archieroques/LEDMatrix/README.md

# LEDMatrix
An LED Matrix project, originally completed for a Gold CREST award. 

All stuff is Open Source - Released under CC-BY-SA-NC 3.0

Matrix isn't necessarily 100% working - you were warned - no guarantees!
