archieroques/LEDMatrix/LEDMatrixPres_FINAL.pdf

# LED Matrix

## Research

Screen image¹

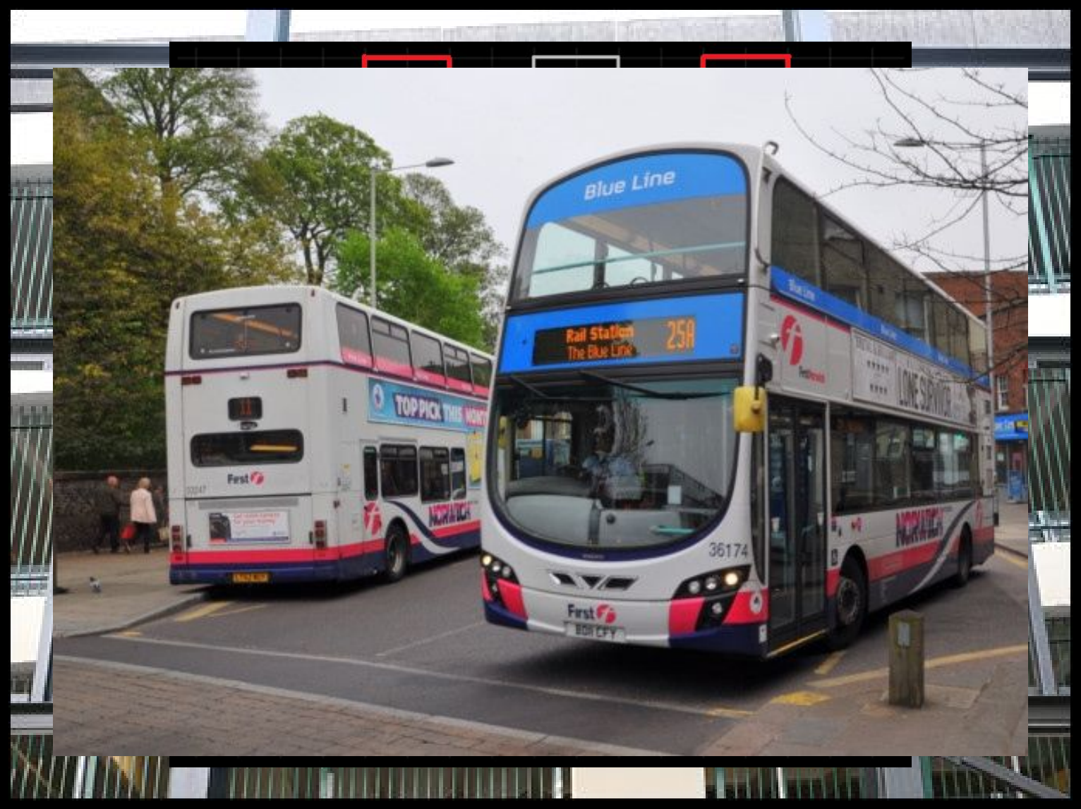
[picture p11: figure]

, bus image²

## Design

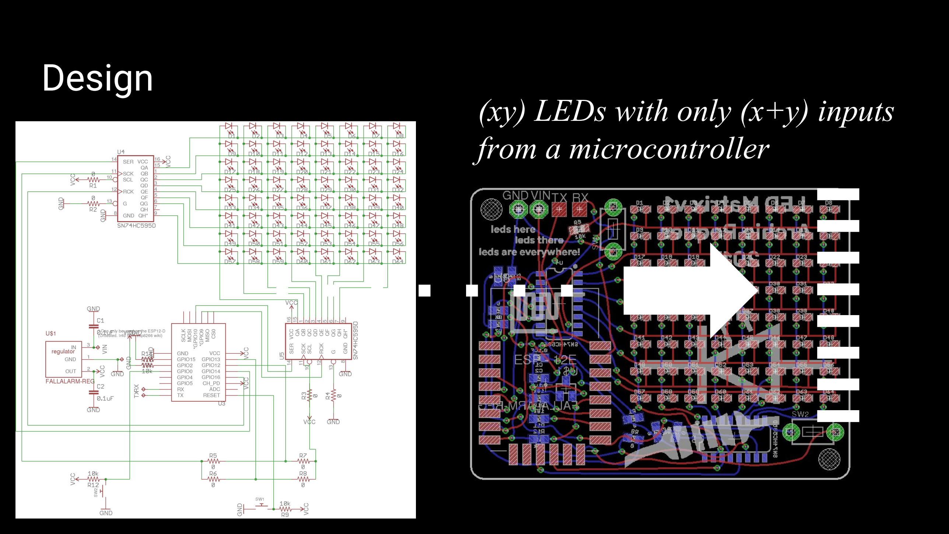
[picture p12: page 3]

### (xy) LEDs with only (x+y) inputs from a microcontroller

## Manufacture

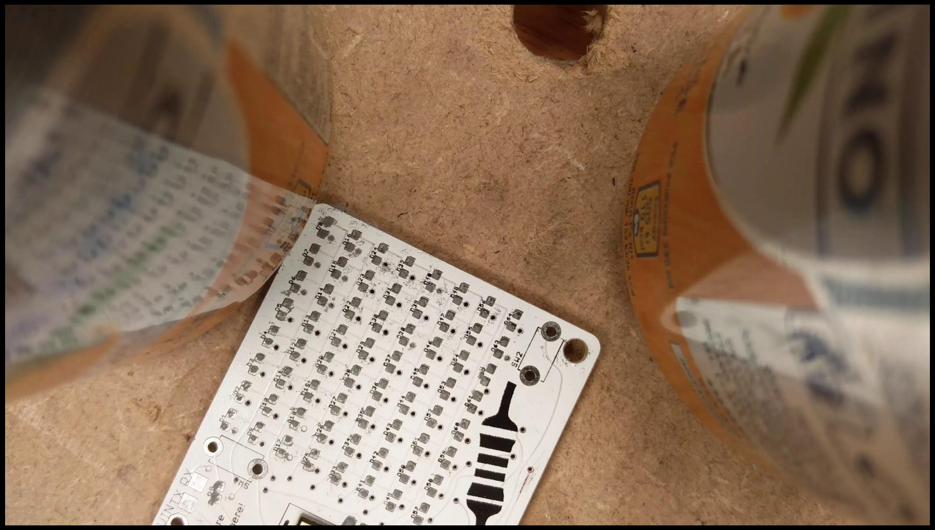
[picture p13: figure]

## Problems and Solutions

## Lessons Learned

## Does it work?

## Future Research

## References

1. http://www.bbc.co.uk/wiltshire/content/image_galleries/swindon_big_screen_building_gallery.shtml?14 (http://www.bbc.co.uk/wiltshire/content/image_galleries/swindon_big_screen_building_gallery.shtml?14)
2. http://www.edp24.co.uk/polopoly_fs/1.3976058.1425384477!/image/image.jpg_gen/derivatives/landscape_630/image.jpg (http://www.edp24.co.uk/polopoly_fs/1.3976058.1425384477!/image/image.jpg_gen/derivatives/landscape_630/image.jpg)

And those mentioned in dissertation.

## Questions
