archieroques/LEDMatrix/matrix.brd

## EAGLE design matrix.brd (2017-07-20)

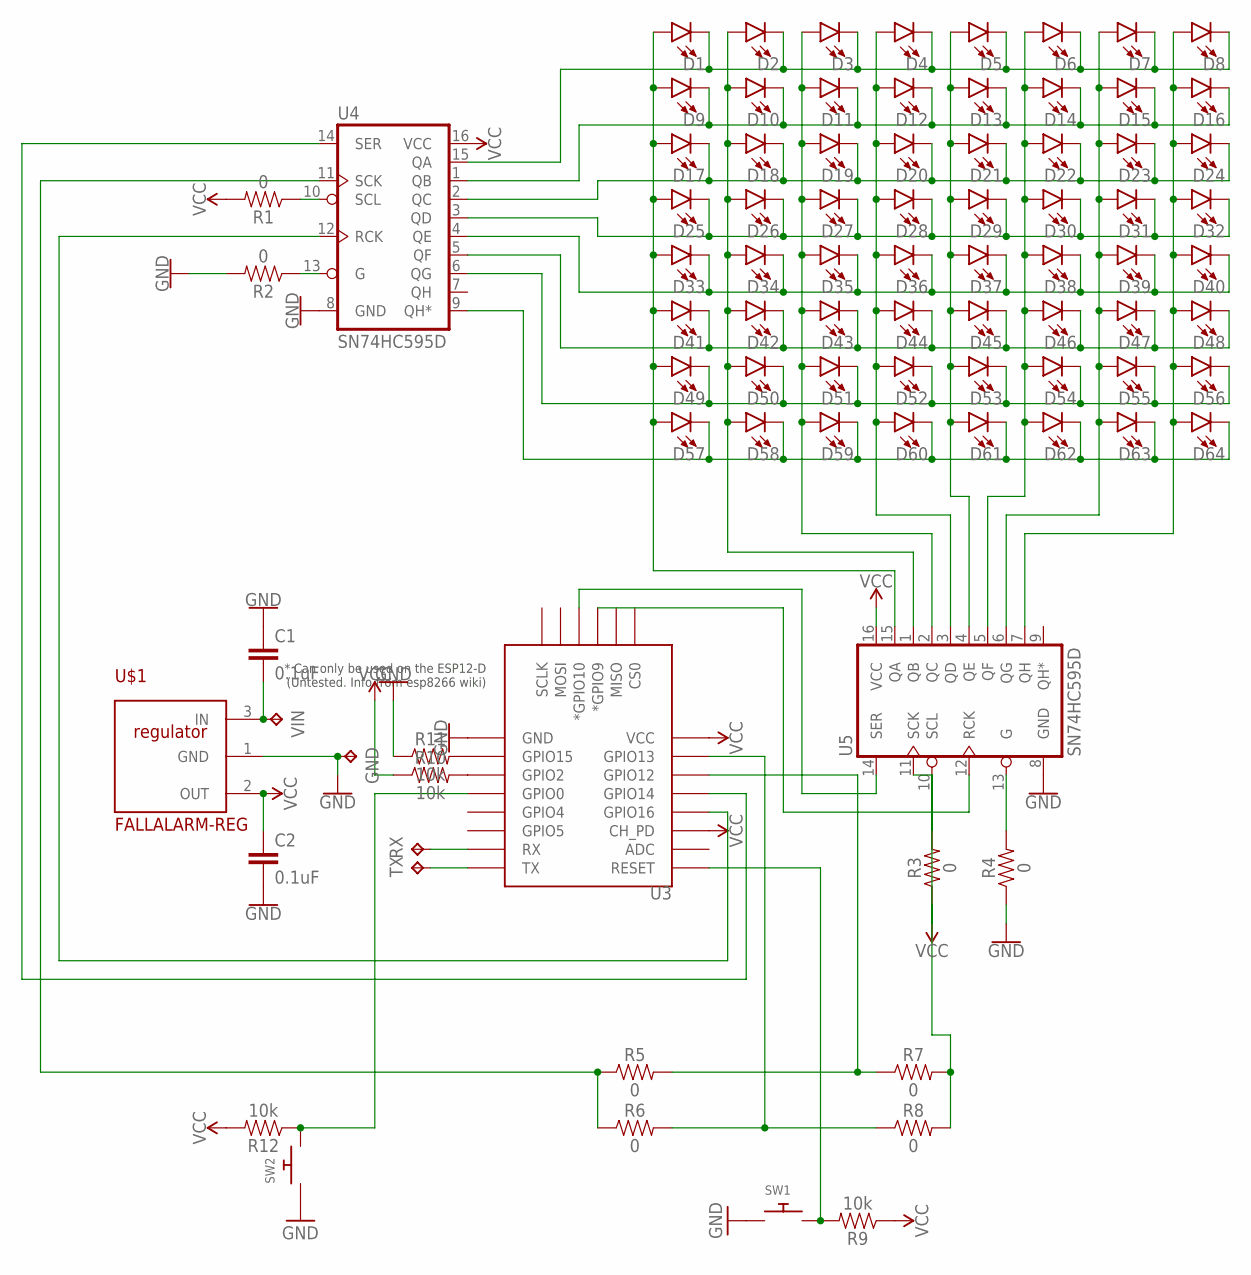
[picture p14: schematic matrix.sch]

Parts:
C1, C2: 0.1uF; 0603
D1, D2, D3, D4, D5, D6, D7, D8, D9, D10, D11, D12, D13, D14, D15, D16, D17, D18, D19, D20, D21, D22, D23, D24, D25, D26, D27, D28, D29, D30, D31, D32, D33, D34, D35, D36, D37, D38, D39, D40, D41, D42, D43, D44, D45, D46, D47, D48, D49, D50, D51, D52, D53, D54, D55, D56, D57, D58, D59, D60, D61, D62, D63, D64: LED0603; LED-0603
GND: TPPAD1-17; P1-17
R1, R2, R3, R4, R5, R6, R7, R8: 0; 0603
R9, R10, R11, R12: 10k; 0603
RX: TPTP20SQ; TP20SQ
SW1, SW2: SWITCH_PUSHBUTTONEVQ-PE; TACT_PANA-EVQ
TX: TPTP20SQ; TP20SQ
U3: ESP12ESMD; ESP12E-SMD
U4, U5: SN74HC595D; SO16
U$1: FALLALARM-REG; SOT23
VIN: TPPAD1-17; P1-17

Connections:
GND: C1.1, C2.2, GND.TP, R2.2, R4.1, R11.1, SW1.P$1, SW2.P$1, U3.GND, U4.8 (GND), U5.8 (GND), U$1.1 (GND)
unnamed: D1.C, D2.C, D3.C, D4.C, D5.C, D6.C, D7.C, D8.C, U4.15 (QA)
unnamed: TX.TP, U3.TXD0 (TX)
unnamed: D1.A, D9.A, D17.A, D25.A, D33.A, D41.A, D49.A, D57.A, U5.15 (QA)
unnamed: D2.A, D10.A, D18.A, D26.A, D34.A, D42.A, D50.A, D58.A, U5.1 (QB)
unnamed: D3.A, D11.A, D19.A, D27.A, D35.A, D43.A, D51.A, D59.A, U5.2 (QC)
unnamed: D4.A, D12.A, D20.A, D28.A, D36.A, D44.A, D52.A, D60.A, U5.3 (QD)
unnamed: D5.A, D13.A, D21.A, D29.A, D37.A, D45.A, D53.A, D61.A, U5.4 (QE)
unnamed: D6.A, D14.A, D22.A, D30.A, D38.A, D46.A, D54.A, D62.A, U5.5 (QF)
unnamed: D7.A, D15.A, D23.A, D31.A, D39.A, D47.A, D55.A, D63.A, U5.6 (QG)
unnamed: D8.A, D16.A, D24.A, D32.A, D40.A, D48.A, D56.A, D64.A, U5.7 (QH)
unnamed: D17.C, D18.C, D19.C, D20.C, D21.C, D22.C, D23.C, D24.C, U4.2 (QC)
unnamed: D25.C, D26.C, D27.C, D28.C, D29.C, D30.C, D31.C, D32.C, U4.3 (QD)
unnamed: D9.C, D10.C, D11.C, D12.C, D13.C, D14.C, D15.C, D16.C, U4.1 (QB)
unnamed: D33.C, D34.C, D35.C, D36.C, D37.C, D38.C, D39.C, D40.C, U4.4 (QE)
unnamed: D41.C, D42.C, D43.C, D44.C, D45.C, D46.C, D47.C, D48.C, U4.5 (QF)
unnamed: U3.GPIO14, U4.14 (SER)
unnamed: U3.GPIO10 (*GPIO10), U5.14 (SER)
unnamed: U3.GPIO9 (*GPIO9), U5.12 (RCK)
unnamed: U3.GPIO16, U4.12 (RCK)
unnamed: R1.1, U4.10 (SCL)
unnamed: R3.2, U5.10 (SCL)
unnamed: R2.1, U4.13 (G)
unnamed: R4.2, U5.13 (G)
unnamed: R5.1, R6.1, U4.11 (SCK)
unnamed: D57.C, D58.C, D59.C, D60.C, D61.C, D62.C, D63.C, D64.C, U4.9 (QH*)
unnamed: C1.2, U$1.3 (IN), VIN.TP
unnamed: RX.TP, U3.RXD0 (RX)
unnamed: R5.2, R7.1, U3.GPIO12
unnamed: D49.C, D50.C, D51.C, D52.C, D53.C, D54.C, D55.C, D56.C, U4.6 (QG)
unnamed: R10.2, U3.GPIO2
unnamed: R11.2, U3.GPIO15
unnamed: R9.2, SW1.P$2
unnamed: R6.2, R8.1, U3.GPIO13
unnamed: R7.2, R8.2, U5.11 (SCK)
unnamed: R12.1, SW2.P$2, U3.GPIO0
VCC: C2.1, R1.2, R3.1, R9.1, R10.1, R12.2, U3.CH_PD, U3.VCC, U4.16 (VCC), U5.16 (VCC), U$1.2 (OUT)

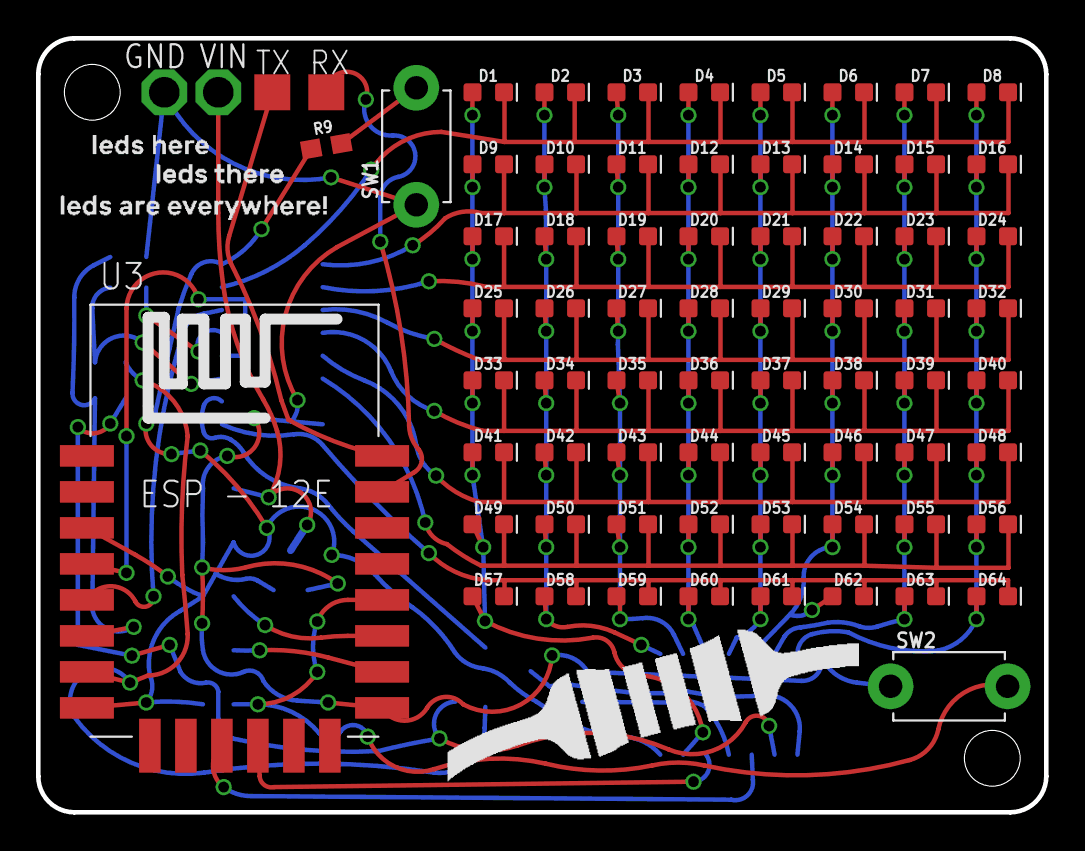
[picture p15: board matrix.brd from above]

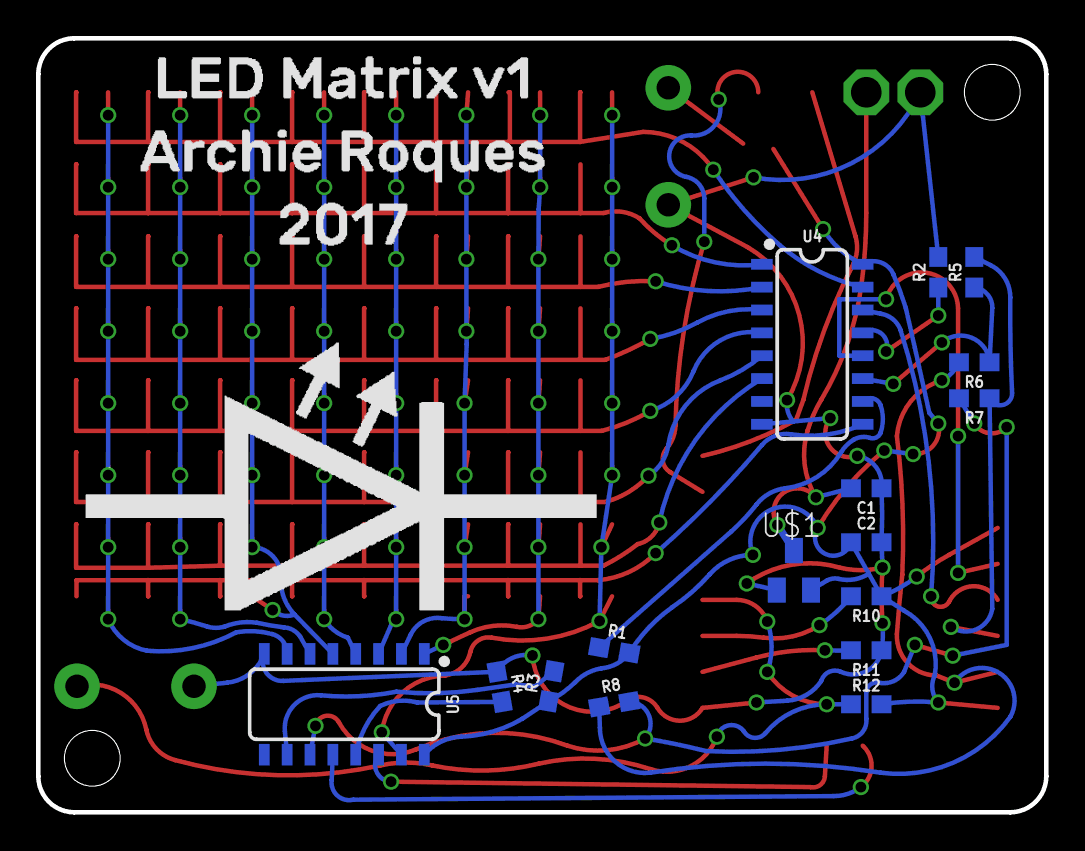
[picture p16: board matrix.brd from below]

Board: 2 copper layers, 56.0 x 43.0 mm, 88 parts (16 on the bottom side), 37 nets.
